Inconel-oh-el/VFD_Clock/Schematic_VFD_Clock.pdf

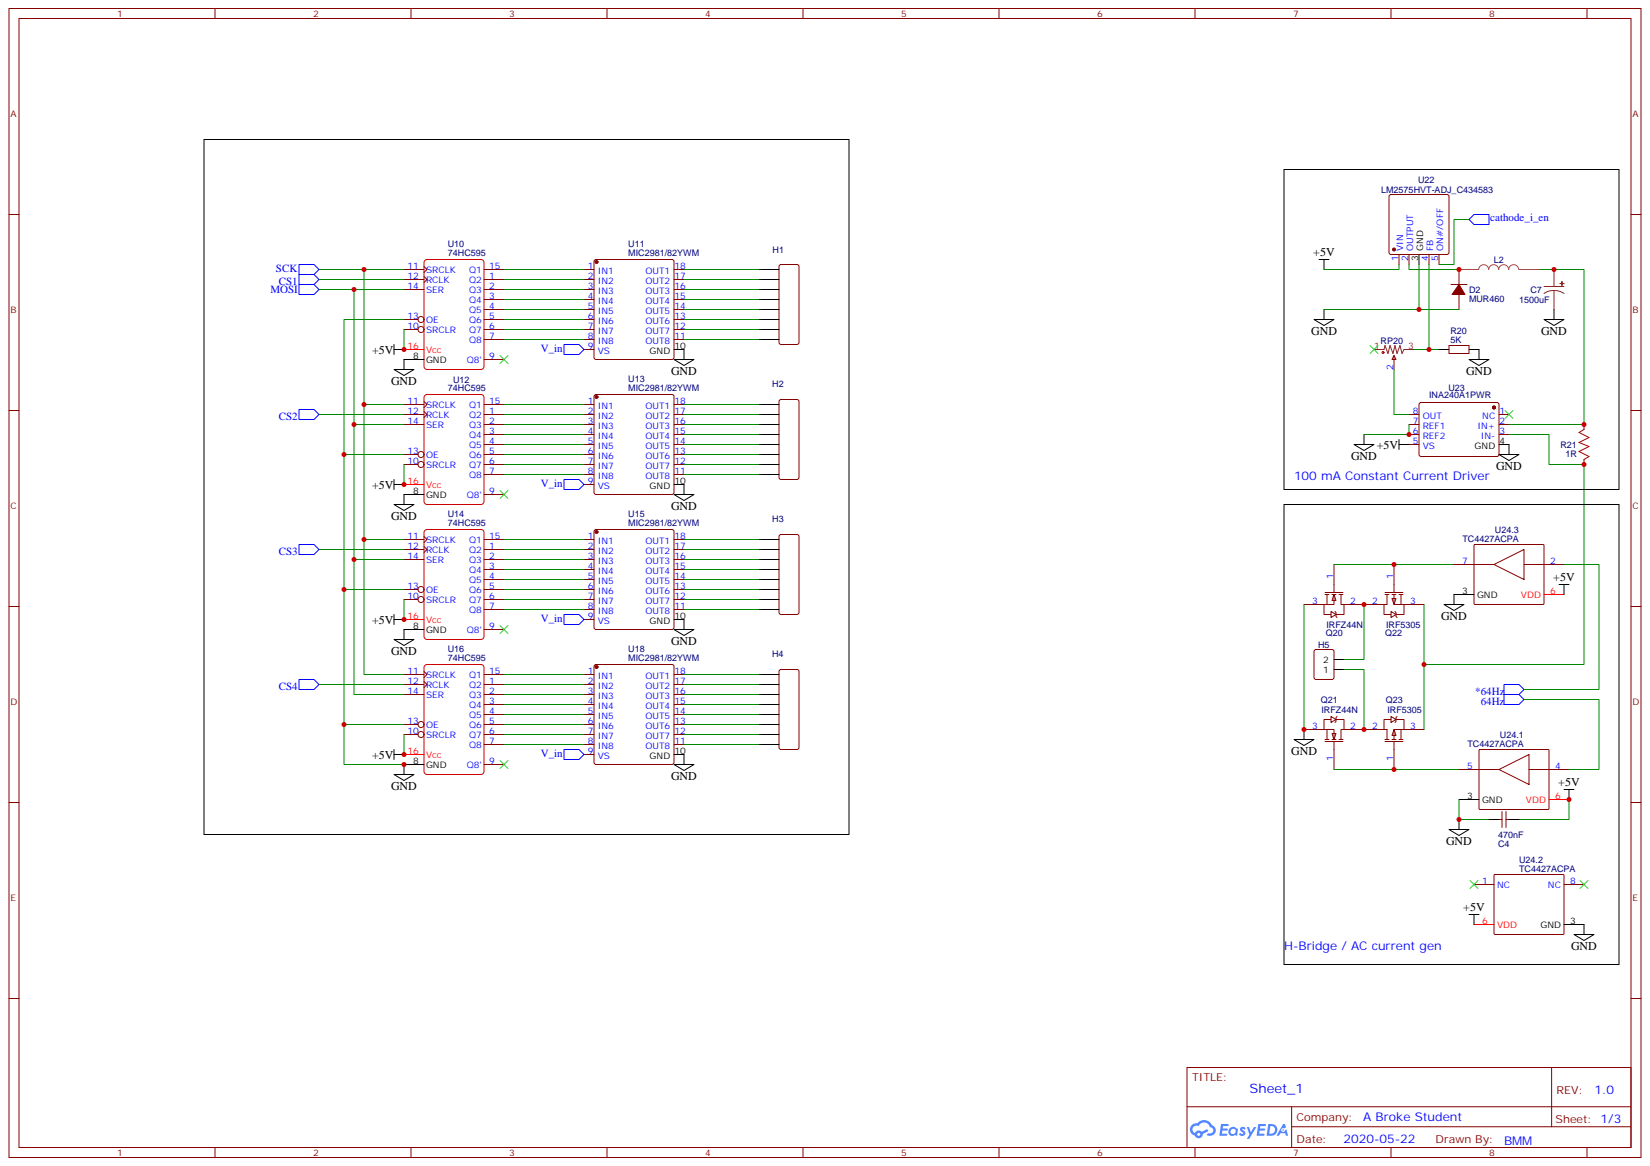
[picture p1: page 1]

ON#/OFF 5 FB 4 GND 3 OUTPUT 2 VIN 1

100 mA Constant Current Driver

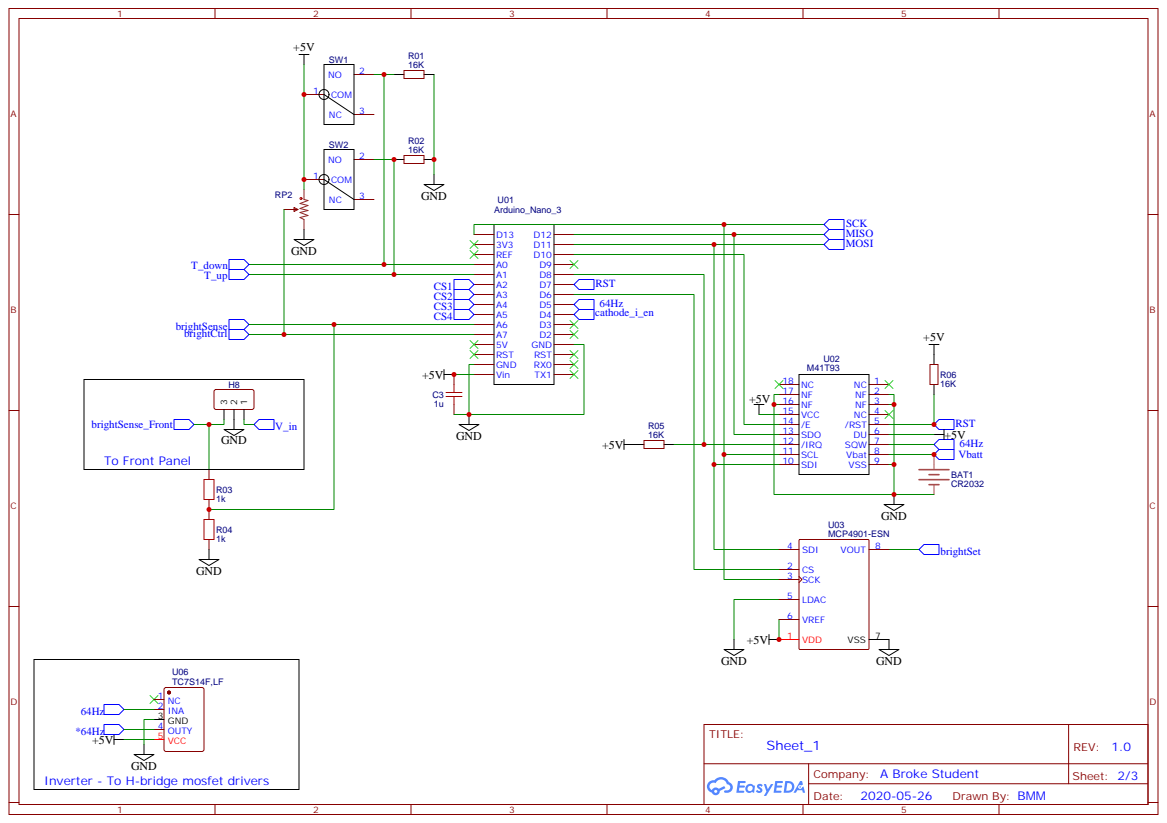
[picture p2: page 2]

VSS 9 SDI 10 SCL 11 /IRQ 12 SDO 13 /E 14 VCC 15 NF 16 NF 17 NC 18

Inverter - To H-bridge mosfet drivers

## 5 Volt Switching Regulator

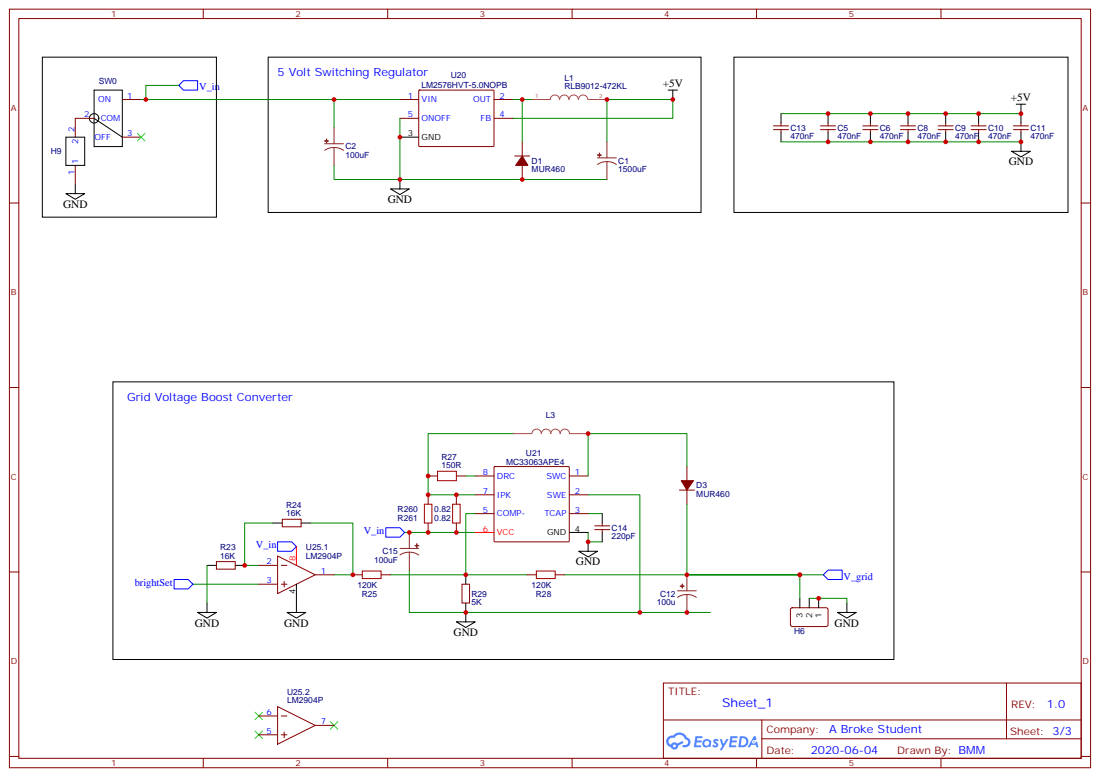
[picture p3: page 3]

Grid Voltage Boost Converter
